unrelatedlabs/DayShift/measuring timing.jpg

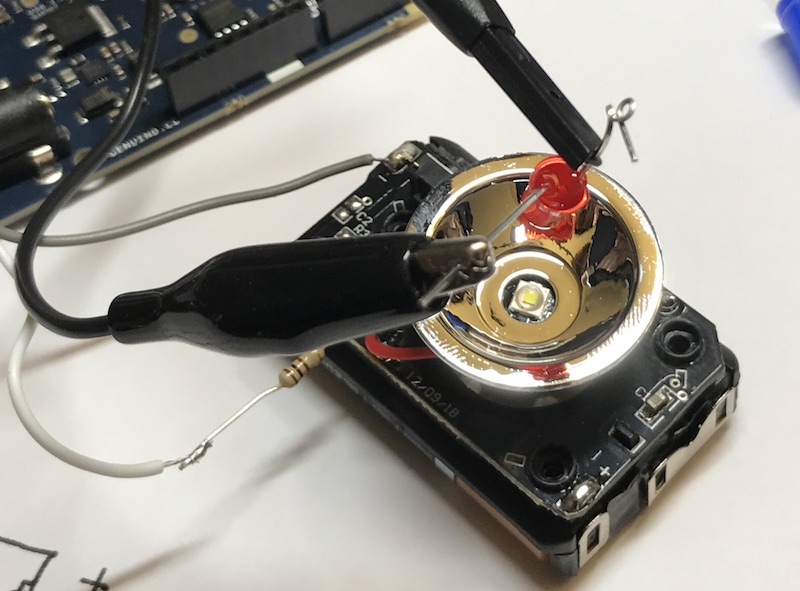
measuring timing.jpg
