unrelatedlabs/DayShift/signal.jpg

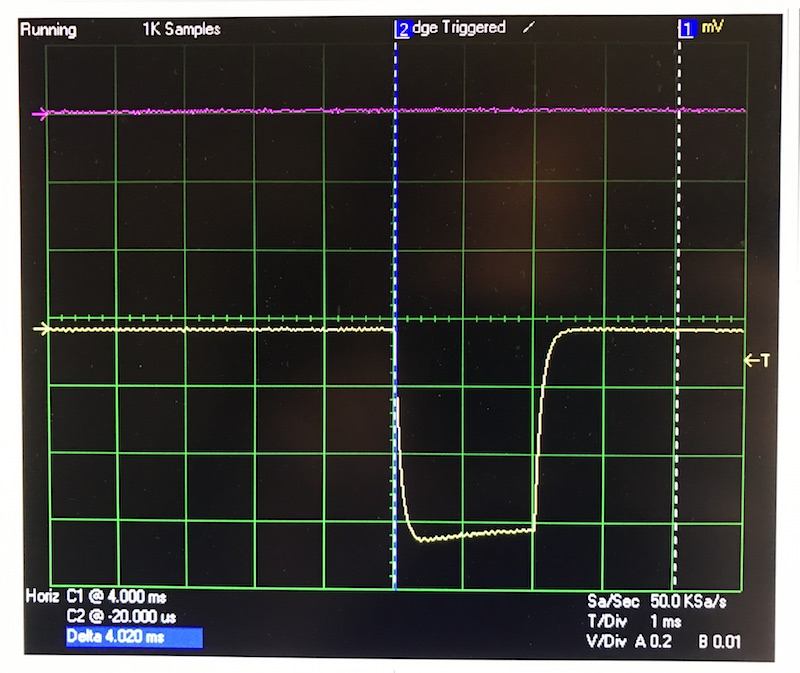
signal.jpg
